uchan-nos/eleclab/README.md

# eleclab

「uchan の電子工作ラボ」の実験プログラムを集めたリポジトリです。

## ライセンス

各プログラムには、別途指定されない場合は MIT ライセンス（ライセンス文は [LICENSE](./LICENSE) に記載）が適用されます。

サブディレクトリにライセンスファイルが置いてあったり、個別のファイル内にライセンスが書かれている場合、そちらの内容が優先されます。
