uchan-nos/eleclab/ch32v003fun_projects/acrylic-stand-illumination/README.md

# 本ソフトウェアについて

X86-ILLUMIBED-1 用のファームウェアです。
