uchan-nos/eleclab/tn9k_psram_sample/logic-analysis.png

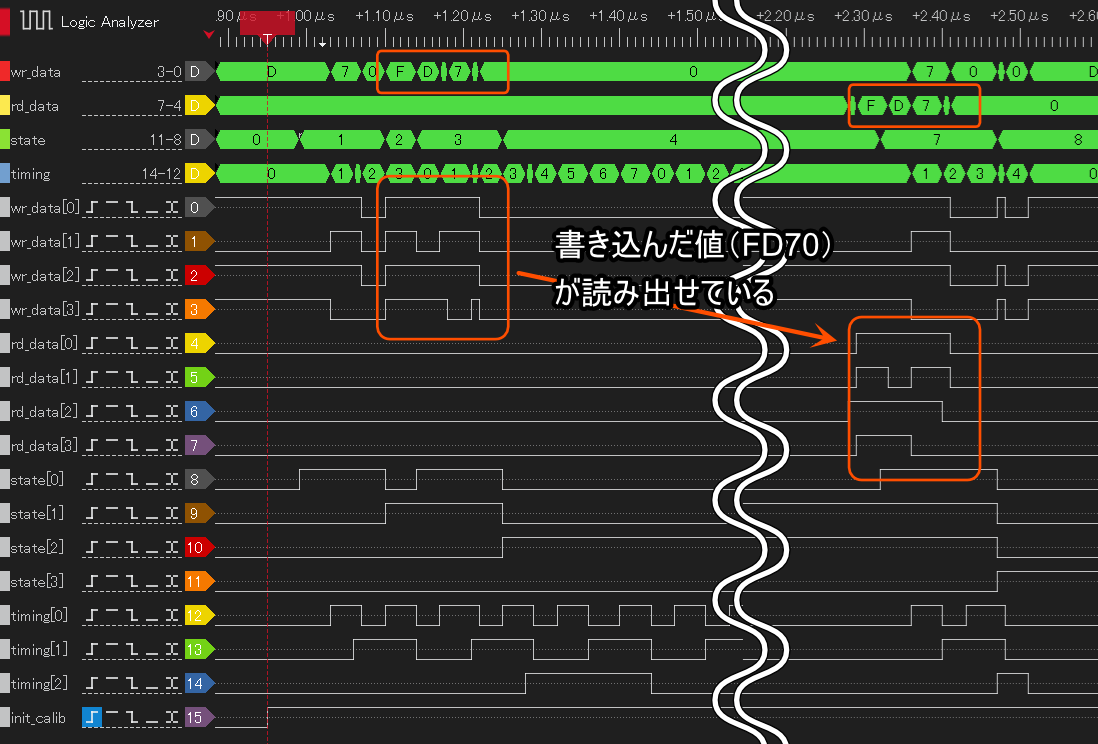
tn9k_psram_sample/logic-analysis.png
