uchan-nos/eleclab/kicad_library/3dmodels/SSR21H.step

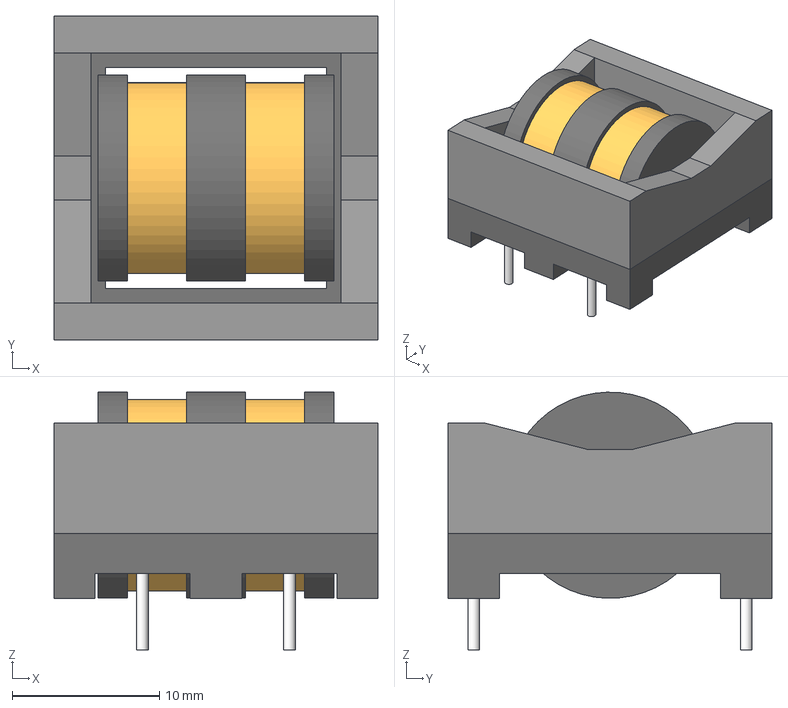
[picture p2: CAD file, 2025-01-06]
kicad_library/3dmodels/SSR21H.step
22.0 x 22.0 x 17.5 mm
base_part
core_part
bobbin_part
coil_part
pins_part
