uchan-nos/eleclab/kicad_library/3dmodels/SC2004C.step

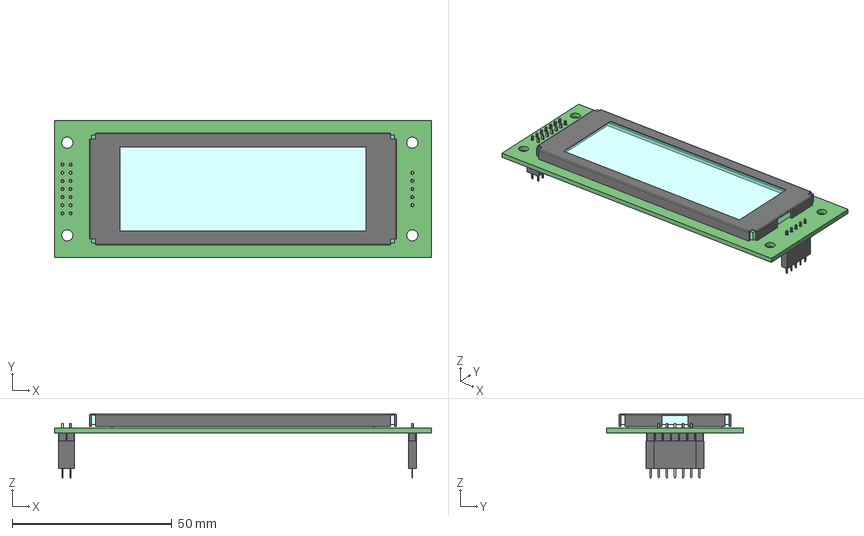
[picture p3: CAD file, 2024-09-29]
kicad_library/3dmodels/SC2004C.step
118.0 x 43.0 x 19.9 mm
26adc5a8-7c93-11ef-afe9-010101010000_part
26adc5a9-7c93-11ef-a801-010101010000_part
26adc5aa-7c93-11ef-9580-010101010000_part
26adc5ab-7c93-11ef-85b0-010101010000_part
269dade9-7c93-11ef-bf7b-010101010000_part x 19
269dadea-7c93-11ef-a5ac-010101010000_part x 19
26a0ac92-7c93-11ef-86b3-010101010000_part
pinsocket_pin_00_part x 2
pinsocket_pin_01_part x 2
pinsocket_pin_02_part x 2
pinsocket_pin_03_part x 2
pinsocket_pin_04_part x 2
pinsocket_pin_05_part
pinsocket_pin_06_part
pinsocket_pin_10_part
pinsocket_pin_11_part
pinsocket_pin_12_part
pinsocket_pin_13_part
pinsocket_pin_14_part
pinsocket_pin_15_part
pinsocket_pin_16_part
26a3a743-7c93-11ef-b4bb-010101010000_part
