uchan-nos/eleclab/kicad_library/3dmodels/OLED_Display_I2C.step

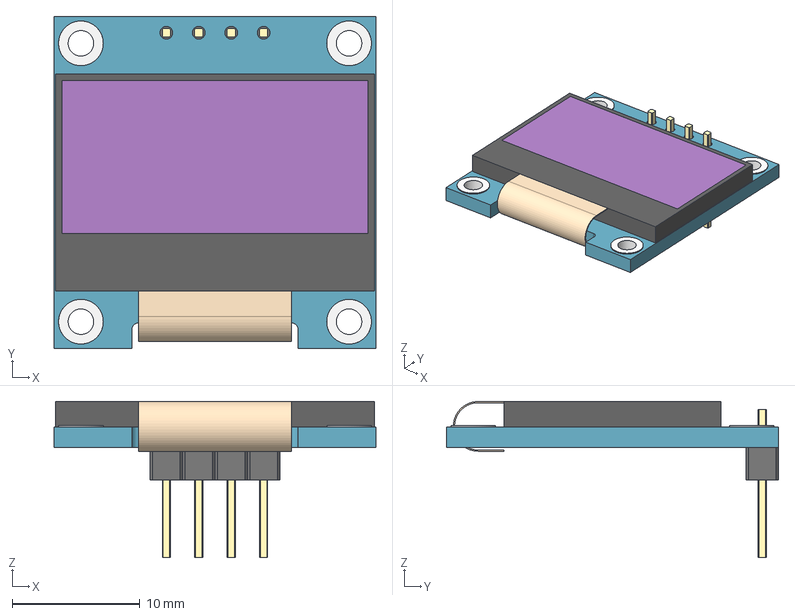
[picture p4: CAD file, 2024-09-29]
kicad_library/3dmodels/OLED_Display_I2C.step
25.2 x 26.0 x 12.2 mm
e8d9c5b4-7c9b-11ef-9adb-010101010000_part
e8d9c5b5-7c9b-11ef-93bc-010101010000_part
e8d9c5b6-7c9b-11ef-a96c-010101010000_part
e8d9c5b7-7c9b-11ef-8ddb-010101010000_part
e8d9c5b8-7c9b-11ef-84d2-010101010000_part
e8dfa473-7c9b-11ef-b0ce-010101010000_part x 4
e8dfcb7a-7c9b-11ef-a093-010101010000_part x 4
