uchan-nos/eleclab/kicad_library/3dmodels/SK6812MINI-E.step

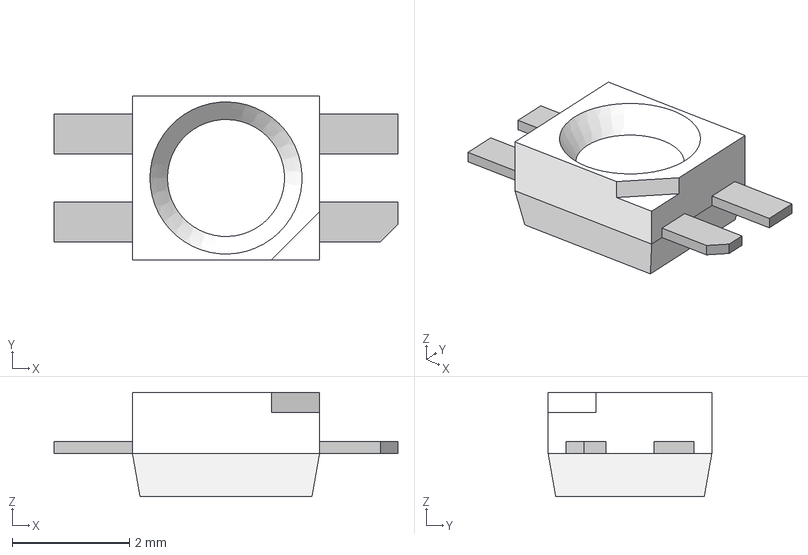
[picture p5: CAD file, 2024-09-26]
kicad_library/3dmodels/SK6812MINI-E.step
5.88 x 2.80 x 1.78 mm
977b6cac-199f-11ef-8f02-f09e4a5f3376_part
977b6cad-199f-11ef-af91-f09e4a5f3376_part
977b6cae-199f-11ef-962f-f09e4a5f3376_part
977b8fc3-199f-11ef-b690-f09e4a5f3376_part
977b8fc4-199f-11ef-89b7-f09e4a5f3376_part
977b8fc5-199f-11ef-8a7a-f09e4a5f3376_part
