uchan-nos/eleclab/kicad_library/3dmodels/MJ-179PH.step

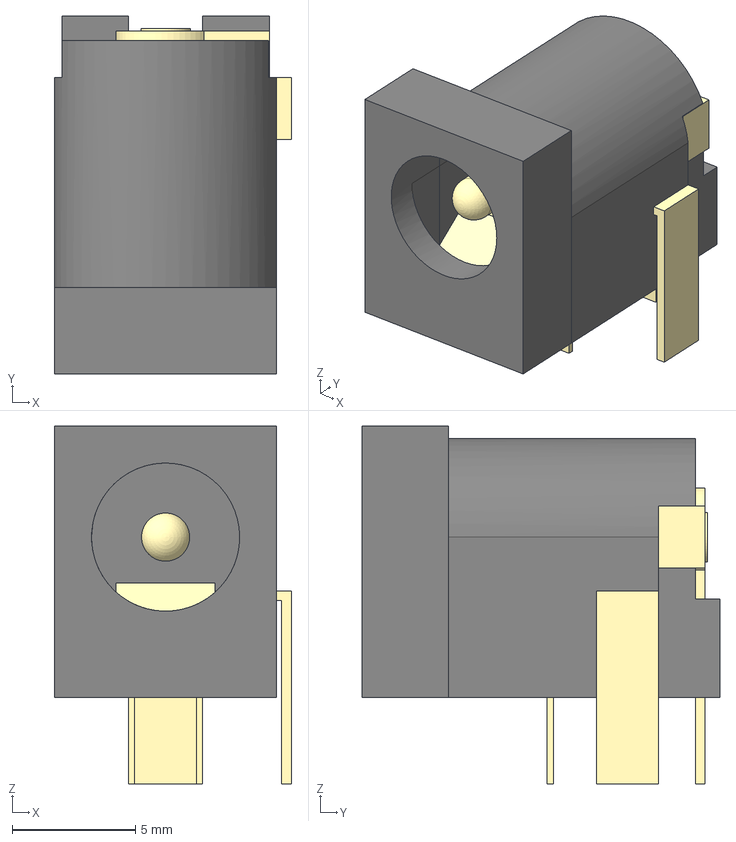
[picture p6: CAD file, 2024-09-26]
kicad_library/3dmodels/MJ-179PH.step
9.60 x 14.5 x 14.5 mm
35873ad6-b5bd-11ee-b889-010101010000_part
35873ad7-b5bd-11ee-99ae-010101010000_part
35873ad8-b5bd-11ee-b063-010101010000_part
35873ad9-b5bd-11ee-ba4f-010101010000_part
35873ada-b5bd-11ee-be6d-010101010000_part
35873adb-b5bd-11ee-923f-010101010000_part
35873adc-b5bd-11ee-acbd-010101010000_part
