uchan-nos/eleclab/kicad_library/3dmodels/GroveConnector_110990037.step

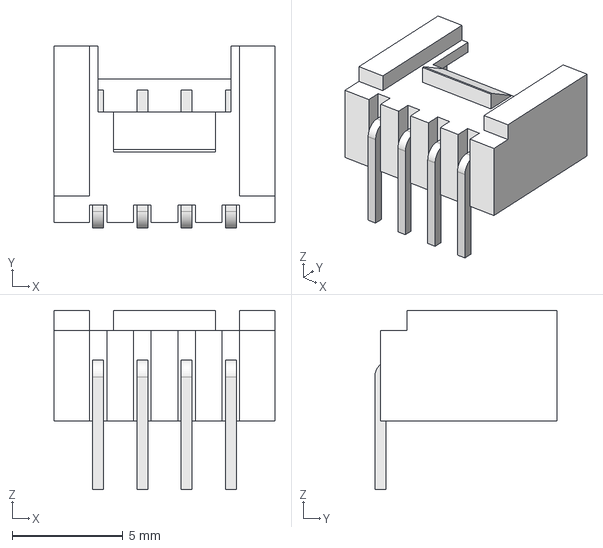
[picture p7: CAD file, 2024-09-26]
kicad_library/3dmodels/GroveConnector_110990037.step
10.0 x 8.25 x 8.10 mm
4e710518-58ad-11ef-8c46-f09e4a5f3376_part
4e712c02-58ad-11ef-9284-f09e4a5f3376_part
