uchan-nos/eleclab/kicad_library/3dmodels/KDJ03-5.step

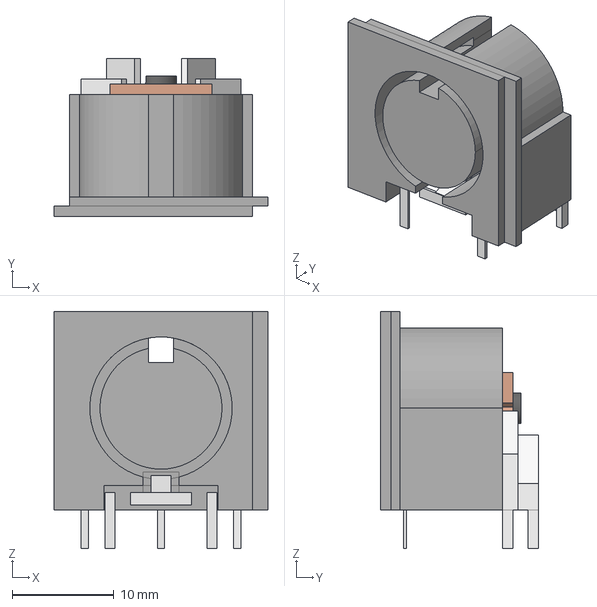
[picture p8: CAD file, 2024-09-26]
kicad_library/3dmodels/KDJ03-5.step
21.0 x 15.5 x 23.3 mm
