uchan-nos/eleclab/kicad_library/3dmodels/CNZ1023.step

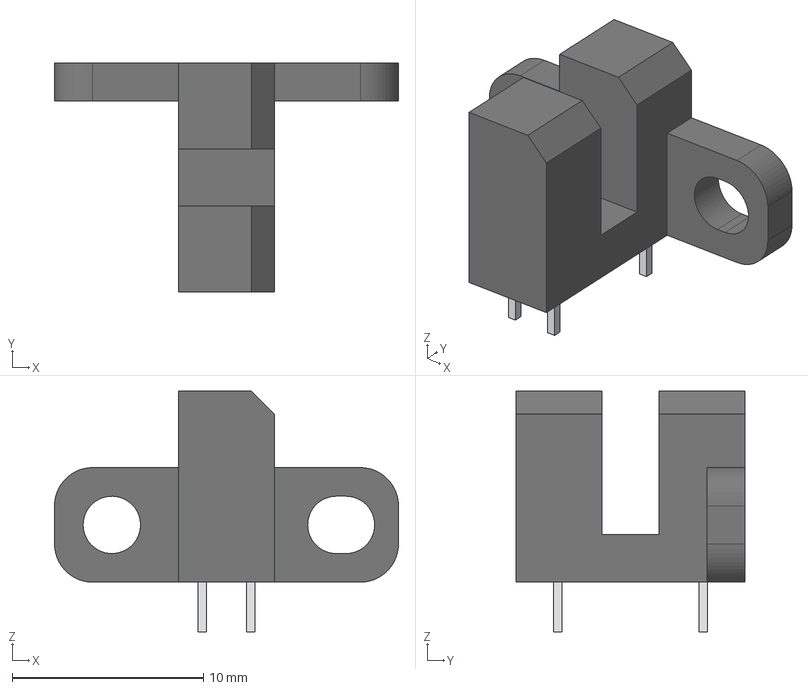
[picture p9: CAD file, 2024-09-26]
kicad_library/3dmodels/CNZ1023.step
18.0 x 12.0 x 12.6 mm
body_part
arm_part
leg1_part
leg2_part
leg3_part
leg4_part
