uchan-nos/eleclab/kicad_library/3dmodels/OS102011MA1QN1.step

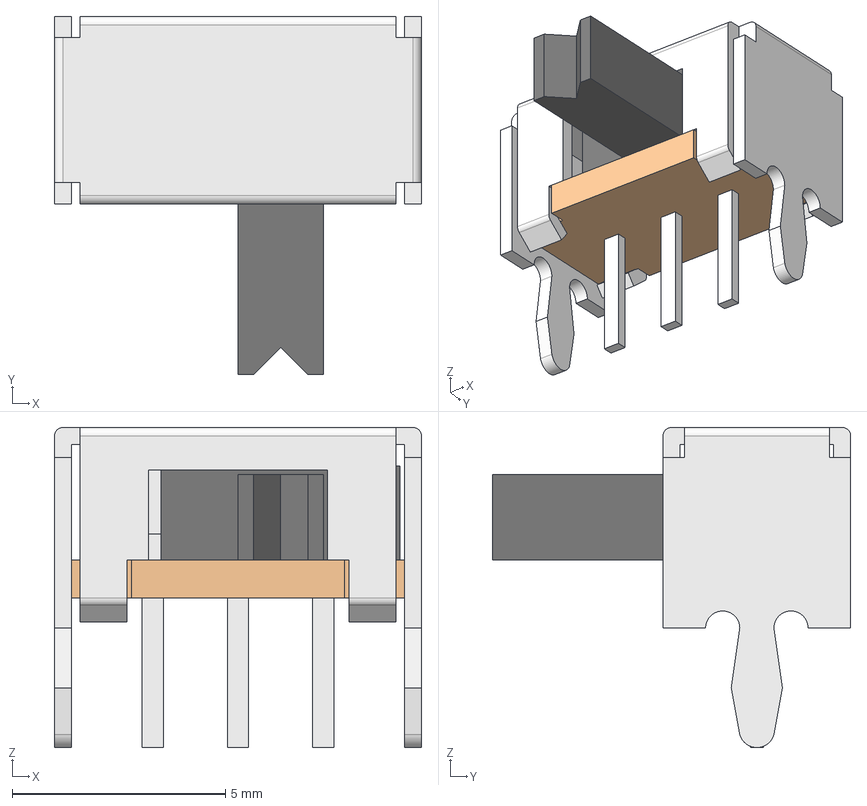
[picture p10: CAD file, 2024-09-26]
kicad_library/3dmodels/OS102011MA1QN1.step
8.60 x 8.40 x 7.50 mm
f37e8119-d142-11ee-b0e5-010101010000_part
f37ea82e-d142-11ee-98c6-010101010000_part
f37ea82f-d142-11ee-9b82-010101010000_part
f37ea830-d142-11ee-8c88-010101010000_part
pin1_part x 3
