uchan-nos/eleclab/led_tester/README.md

## LED 抵抗計算機

LED に特定の電流を流したときの抵抗値を自動的に計算する装置の回路図とプログラムを格納しています。
装置の紹介は [LED抵抗計算機](https://elchika.com/article/dbb9da94-601a-4d9f-a0b8-8a3aeecb87ea/) を参照してください。

led_tester.X は [MPLAB X IDE](https://www.microchip.com/en-us/tools-resources/develop/mplab-x-ide) のプロジェクトです。
IDE で開けばビルドや PIC への書き込みが可能です。

## ライセンス

led_tester.X/mcc_generated_files に含まれるファイルの著作権は Microchip 社にあります。
また、それらのコードは Microchip 社の製品でのみ利用できます。
詳しくはファイル先頭に書いてあるコメントを参照してください。

その他のファイルは全体のライセンス [LICENSE](../LICENSE) に従います。
