uchan-nos/eleclab/ch32v003fun_projects/v003_tests/adc_moving_avg/README.md

# ADC with fixed sampling rate and moving average

This example reads analog values at a fixed rate and calculates moving average.
