uchan-nos/eleclab/pio_projects/nucleo-f446re-zephyr-hello/src/main.c

#include <zephyr/kernel.h>
#include <zephyr/drivers/gpio.h>

static const struct gpio_dt_spec led = GPIO_DT_SPEC_GET(DT_ALIAS(led0), gpios);

void main(void)
{
    int ret;
	bool led_state = true;

    printf("CONFIG_SYS_CLOCK_TICKS_PER_SEC = %d\n", CONFIG_SYS_CLOCK_TICKS_PER_SEC);
	if (!gpio_is_ready_dt(&led)) {
		return 0;
	}

	ret = gpio_pin_configure_dt(&led, GPIO_OUTPUT_ACTIVE);
	if (ret < 0) {
		return 0;
	}

	while (1) {
		ret = gpio_pin_toggle_dt(&led);
		if (ret < 0) {
			return 0;
		}

		led_state = !led_state;
		printf("LED state: %s\n", led_state ? "ON" : "OFF");
		k_msleep(1000);
	}
	return 0;
}
