uchan-nos/eleclab/arbitrary_wave_generator/tangnano/src/gowin_osc/gowin_osc.v

//Copyright (C)2014-2021 Gowin Semiconductor Corporation.
//All rights reserved.
//File Title: IP file
//GOWIN Version: V1.9.8
//Part Number: GW1N-LV1QN48C6/I5
//Device: GW1N-1
//Created Time: Tue Oct 26 18:18:50 2021

module Gowin_OSC (oscout);

output oscout;

OSCH osc_inst (
    .OSCOUT(oscout)
);

defparam osc_inst.FREQ_DIV = 2;

endmodule //Gowin_OSC
