uchan-nos/eleclab/unipolar_stepping_motor_driver/Core/Src/sqrt.c

/*
 * sqrt.c
 *
 *  Created on: Oct 5, 2022

このファイルに含まれる整数根号計算プログラムは http://www.azillionmonkeys.com/qed/sqroot.html から持ってきました。
したがって、このファイルに含まれるソースコードのライセンスは全体のライセンスとは異なり、以下の通りです。

Copyright (c) 2010, Paul Hsieh
All rights reserved.

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
- Redistributions of source code must retain the above copyright notice, this list of conditions and the following disclaimer.

- Redistributions in binary form must reproduce the above copyright notice, this list of conditions
  and the following disclaimer in the documentation and/or other materials provided with the distribution.

- Neither my name, Paul Hsieh, nor the names of any other contributors to the code use may not be used
  to endorse or promote products derived from this software without specific prior written permission.

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
 */

/* by Mark Crowne */
unsigned int mcrowne_isqrt(unsigned long val) {
  unsigned int temp, g=0;

  if (val >= 0x40000000) {
    g = 0x8000;
    val -= 0x40000000;
  }

#define INNER_ISQRT(s)                        \
  temp = (g << (s)) + (1 << ((s) * 2 - 2));   \
  if (val >= temp) {                          \
    g += 1 << ((s)-1);                        \
    val -= temp;                              \
  }

  INNER_ISQRT (15)
  INNER_ISQRT (14)
  INNER_ISQRT (13)
  INNER_ISQRT (12)
  INNER_ISQRT (11)
  INNER_ISQRT (10)
  INNER_ISQRT ( 9)
  INNER_ISQRT ( 8)
  INNER_ISQRT ( 7)
  INNER_ISQRT ( 6)
  INNER_ISQRT ( 5)
  INNER_ISQRT ( 4)
  INNER_ISQRT ( 3)
  INNER_ISQRT ( 2)

#undef INNER_ISQRT

  temp = g+g+1;
  if (val >= temp) g++;
  return g;
}

unsigned julery_isqrt(unsigned long val) {
    unsigned long temp, g=0, b = 0x8000, bshft = 15;
    do {
        if (val >= (temp = (((g << 1) + b)<<bshft--))) {
           g += b;
           val -= temp;
        }
    } while (b >>= 1);
    return g;
}

#include <stdint.h>
uint32_t julery_isqrt64(uint64_t val) {
  uint64_t temp, g=0, b = 0x80000000, bshft = 31;
  do {
      if (val >= (temp = (((g << 1) + b)<<bshft--))) {
         g += b;
         val -= temp;
      }
  } while (b >>= 1);
  return g;
}
