uchan-nos/eleclab/(commit log)

2021-11-05 Sin波を発生する任意波形発生器
2021-11-05 ビルド成果物を無視する
2021-12-30 ライセンスについて明示
2022-01-01 LED抵抗計算機のプログラム一式を追加
2022-01-01 MPLAB X IDEで自動生成されるファイルをignore
2022-01-01 led_tester.XはMPLABでビルドできる旨を追記
2022-01-10 FVRを使用して電流測定の分解能を上げる
    ついでに電流検出抵抗を51Ωから50Ωに変更
2022-01-16 抵抗値計算のバグを修正+表示の微調整
2022-03-27 リフロー炉制御プログラムのひな形を追加
2022-03-27 TMR0を使用してトライアックを位相制御するテスト
2022-09-16 リファクタ
2022-09-16 熱電対と気温センサを読み取る
2022-09-16 ユニポーラステッピングモータ制御テスト
2022-09-16 STM32ツールをバージョンアップ
    - CubeMX 6.4.0 -> 6.6.1
    - Firmware 1.17.0 -> 1.17.2
2022-09-17 main 関数を自動生成し、my_main.c を main.c に統合
2022-09-17 自動生成されたファイルのいくつかを追加
    これらのファイルには将来的にユーザ独自の変更を加える可能性があるため
2022-09-17 STM32CubeIDE の操作を簡単に説明
2022-09-19 モータ速度制御ロジックを追加
2022-09-21 タイマーの PWM 制御から GPIO 制御に変更
2022-10-02 タイマーを使ってだんだん加速させる
2022-10-11 各種 sqrt 関数の速度比較テスト
2023-01-26 左右のモーターを別々に制御する
2023-01-27 MCC再生成に伴う些細な変更
2023-01-28 K熱電対の値をローパスフィルタ
    センサやAD変換のノイズを除去
2023-01-28 気温センサの値もフィルタする
2023-01-29 現在温度にしたがって負荷を制御
2023-01-29 TMR0 の代わりに TMR2 を使う
    TMR2 は自動的にタイマ値がリロードされるので精度が高い
2023-01-29 トライアックのゲート信号を TMR4 を使ってクリアする
2023-01-30 コマンドによる制御機能を追加
2023-02-04 目標温度リストによる管理を導入
2023-02-08 Ni-MH充放電器の制御プログラムを追加 (WIP)
2023-02-10 最初の温度設定をスキップしてしまうバグを修正
2023-02-10 reflow のプロジェクト設定を更新
2023-02-10 クロックを8MHz→16MHzに更新
    UART のエラー率を低減するため
2023-02-16 最大出力時にヒーターが停止する問題を修正
2023-02-16 WIP: 放電機能の対応
2023-02-21 WIP: 新ボードへの対応
2023-03-12 ZCD 試験用プログラムのひな形を作成
2023-03-12 ZCD の結果を IO に出力
2023-03-12 ZCD 出力を CLC で高速に出力
2023-03-14 Ni-MH 充放電基板の突入電流実験用プログラムを追加
2023-03-15 突入電流測定時、オペアンプを確実に ON させる
2023-03-15 Ni-MH Charger のコンパイルエラーを解消
2023-03-16 Ni-MH 充放電器の LED を sin 波で点滅させる
2023-03-16 Ni-MH 充放電器の電池接続検知を修正
2023-03-16 Ni-MH 充放電器の LED 点滅を全部割り込みで処理する
2023-03-16 Ni-MH の LCD に電池電圧を表示する
2023-03-16 Ni-MH の LCD にモードを表示
2023-03-17 Ni-MH 充放電のロジックをひととおり追加
2023-06-13 NeoPixelプロトコルの制御プログラムを追加
2023-06-13 LEDの色を1粒ずつずらす処理
2023-06-14 RGBLEDのタイマ割り込みハンドラを最適化
2023-06-17 LED 信号を送信中には TMR2 割り込みだけ処理する
2023-06-17 UARTからLED送信データを受け取る
2023-06-21 CH32V003J4M6の実験プログラムを追加
    IDE: MounRiver Studio 1.85
2023-06-21 IDEのプロジェクト定義ファイルを追加
2023-06-21 CDTの設定ファイルを追加
2023-06-21 CDTの設定ファイルをgitignoreから除外
2023-06-21 自動生成された main.c を一旦削除
2023-06-21 TIM1 を使って PWM 出力を行うサンプルを追加
2023-06-22 I2CでLED色情報を受け取れるようにする
2023-06-22 ファイルの文字コードを明示的にUTF-8とする
2023-06-25 OC4PE を有効化したときの挙動の実験
2023-06-27 TIM1 の周期を NeoPixel 用と視認用で変えられるようにする
2023-06-28 DMA を使ってタイマの PWM パルス幅を調整する
2023-06-28 NeoPixel幅の0/1パルスを出し続ける
2023-07-02 配列でLED輝度情報を与える＆割り込み処理時間を表示
2023-07-08 CH32V003J4M6 の割り込みネスト実験プログラムを追加
2023-07-10 VSCode でデバッグを行う設定を追加
2024-06-24 ch32v003 用のフルカラー LED 制御ファームウェアを追加
2024-06-24 スイッチでLED発光色を選択する
2024-09-26 Add original KiCad library
    [CNZ1023.step, GroveConnector_110990037.step, KDJ03-5.step, MJ-179PH.step, OS102011MA1QN1.step, SK6812MINI-E.step]
2024-09-26 Add a footprint for OLED Display
2024-09-29 Add 3d models for OLED display and LCD SC2004C
    [OLED_Display_I2C.step, SC2004C.step]
2024-10-06 sw2でLEDの輝度を全体的に調整する
2024-10-06 SW1 長押しで色選択を初期化する
2024-10-06 スイッチ操作を別モジュールに切り出す
2024-10-09 微小電流計の制御プログラムを追加
2025-01-06 KiCadライブラリに部品を追加
    - Symbols
    - Omron MOSFET Relay G3VM-201G2
    - Small version of relay SPST NO
    - Omron Mechanical Relay G2R-1A
    - Diode Bridge TS260S
    - Footprints
    - Some Choke coils
    - TS260S
    - MJ-8435
2025-01-06 VDD が正確に 5V でないときに電流値を補正する
2025-01-06 SSR21Hの3Dモデルを追加
    [SSR21H.step]
2025-01-06 メーカー提供の3Dモデルを既存フットプリントに追加
2025-01-06 バリスタのピンピッチが正確に 5mm になるように調整
2025-02-01 はんだこて切り忘れ防止装置のファームウェアを追加
2025-02-08 はんだこて切り忘れ防止装置のファームウェア改良
    - リレー動作の間はセンサーを無視する
    - 動作時間を 2 分に伸ばす
2025-02-20 ch32v003funの更新に追従しビルドシステムを修正
2025-02-20 CH32V203K8T6 用のLチカサンプルを追加
2025-02-20 add script to attach wch-link
2025-02-22 WCH-LinkE を一般ユーザーで使えるようにする Udev ルールを追加
2025-02-23 Add a test program for PWM
2025-02-23 Add a test program for TIM2 encoder mode
2025-02-23 Add a test program for NRST pin configuration
2025-03-23 ADC を連続的に行い移動平均を計算するサンプルを追加
2025-04-01 MSMP-DBG用のプログラムのひな形を追加
2025-04-01 MSPS-DBGのイベントリストを作成
2025-04-02 間違ったコメントを訂正
2025-04-02 設計更新、MSMP msg 用構造体の作成
2025-04-07 信号記録モードと start/dump rec コマンドを追加
2025-04-07 受信メッセージ記録機能を追加（WIP）
2025-04-08 メッセージ記録・表示機能を追加
2025-04-08 自ノードの MSMP アドレスを設定可能に
2025-04-09 MSMP 送受信同時デバッグモードを追加
2025-04-09 割り込みルーチンの中で長時間の処理をしない
2025-04-09 MSMPデバッガにヘルプコマンドを追加
2025-04-09 MSMPデバッガの波形表示にビット位置の情報を追加
2025-04-10 MSMPデバッガにメッセージ送信コマンドsendを追加
2025-04-15 MSMP デバッガをより廉価に作れるよう設計を見直す
2025-04-15 MSMP デバッガの実用に欲しい機能を列挙
2025-04-15 MSMP デバッガのビルドエラー修正
    環境によってグローバル変数の extern 指定の有無が
    エラーになったりならなかったりするようだ。
    [msmp_recorder.c, msmpdbg.c, msmpdbg.h]
2025-04-15 MSMPデバッガに最後のコマンドを再実行する"!!"を追加
2025-04-16 MSMP デバッガが TSM を受信したら整合性を回復する
2025-04-16 MSMP デバッガの状態管理を msmpdbg.c に移管
2025-04-16 MSMP デバッガに自動転送モードを追加
2025-04-17 MSMPデバッガのスタックサイズ推定スクリプトを追加
2025-04-19 add some footprints
2025-04-22 CH32V003のTIM1でPWMを出力するサンプルを追加
2025-04-24 MSMP デバッガに status コマンドを追加
2025-04-24 replace tabs with spaces
    [msmpdbg.c]
2025-08-27 Tang Nano 9K のプロジェクトひな形を追加
    将来的に PSRAM を検証するサンプルにしていく予定
2025-09-03 PSRAM動作検証回路を作成（うまく動かない）
2025-09-03 PSRAMのユーザロジックをclk_outで駆動する
2025-09-03 PSRAMからの読み出しを64ビット幅で検査
2025-09-18 PlatformIOを用いたRPiPico開発のサンプルを追加
2025-09-22 PlatformIO + Zephyr で L チカ
2025-09-22 Zephyr on Nucleo F446RE でマルチスレッド
2025-09-23 DRV8830をZephyrから制御するサンプルを追加
2025-09-29 転送メッセージの宛先アドレスを自動表示する
2026-08-27 I2C用Groveコネクタを追加
2026-10-31 手はんだを意識してフットプリントを調整
2026-10-31 ESP-NOWを利用した送受信コードをSeeed Studioサイトからコピー
    加えて、最新のESP-IDFでビルドできるように微修正
2026-10-31 手元の2台で通信できるように調整
2026-11-02 送信側をLiPoで動作テスト
2026-11-02 コントローラから前後・スピードを送信する（ダミー値）
2026-11-03 リファクタ＆フォーマット調整
    ビルドは試せていない
2026-11-03 ビルドエラーを修正
2026-11-06 コントローラで実際に前後に動かせる
