uchan-nos/eleclab/(notices)

Notices in the files:
unipolar_stepping_motor_driver/Core/Inc/main.h:
Copyright (c) 2022 STMicroelectronics.
All rights reserved.
This software is licensed under terms that can be found in the LICENSE file
